celephicus/sbc2023/README.md

Moved to TSA repo. James to advise details.
