celephicus/sbc2023/Docs/SBC2023-IRcodes.odt

SBC2023 – Serial data and IR remote control codes

IR protocol is NEC with a 16 bit system code and 8 bit command code. We have been testing with a common remote with a System Code of 0xef00, but we can use any other code or IR protocol that is required. We suggest that a System Code is chosen that is not in common use by other equipment.

Motion | System Code | Command Code
Continuous motion while IR is received plus preset run-on (note 1)
| | Hexadecimal
Head/Backrest up | 0xef00 | 0x04
Head/Backrest Down | | 0x05
Leg/Foot up | | 0x06
Leg/Foot down | | 0x07
Bed Up | | 0x08
Bed Down | | 0x09
Tilt/Trendellenburg up | | 0x0a
Tilt/Trendellenburg down | | 0x0b
Go to Preset positions (note 2)
Preset 1 | 0xef00 | 0x10
Preset 2 | | 0x11
Preset 3 | | 0x12
Preset 4 | | 0x13

Programming instructions (note 3)
Learn Preset 1 | | 0xef00 | 0x14
Learn Preset 2 | | | 0x15
Learn Preset 3 | | | 0x16
Learn Preset 4 | | | 0x17

System Wake-up
Wakeup (note 4) | | 0xef00 | 0x00
Stop (note 5) | | | 0x01

Notes

1. Use with systems that just give a single command burst such as speech recognition. The motor will run for a preset time each time the command is received. A series of repeated commands might be needed to reach a desired position. These commands cannot be cancelled as they just run for a short time anyway.
2. These commands may be aborted by the Stop command, or if any IR command is received, or if any RS232 data is received.
3. Programming instructions must be received 3 times within 2 seconds to be valid and responded to.
4. This is a safety function, and the command must sent in response to the user giving a command such as “Bed wake up”. This will bring the bed control out of standby and be available for additional commands. The controller will revert to standby 60 seconds after the end of the last command. The controller LCD backlight will be active while the unit is ready for commands.
5. The STOP command will always stop any of the Move To Preset Position commands. It is not really required as any other command received when this command is active will stop all motion.

Wired serial data format

Codes sent by serial data are sent 9600 BPS, 8NE as a 4 byte sequence:

Byte 1,2 – System code MSB first

Byte 3 – Command code

Byte 4 – Checksum consisting of simple 8 bit addition of previous 3 bytes

E.g to send command “Head Up” the bytes “EF 00 04 F3” are sent.

P:\Bed Controls\2022SBC\SBC2022-IRcodes.docx
