celephicus/sbc2023/Hardware/Tom's Schematic.pdf

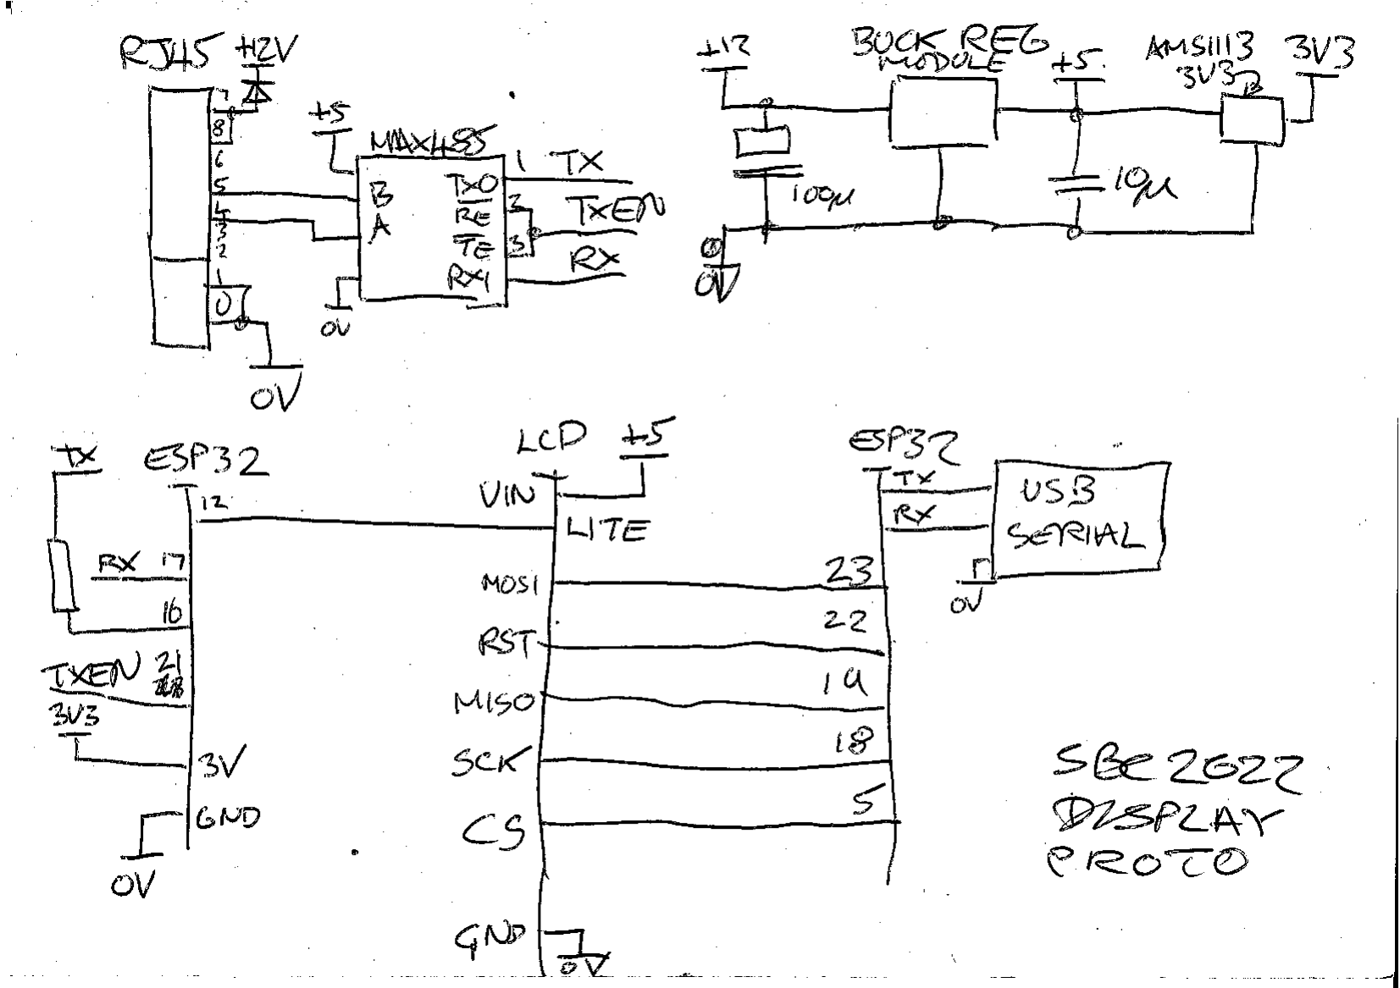
[picture p1: page 1]
