celephicus/sbc2023/Hardware/Workbook.ods

Sheet: Sheet5
Hash 46d2044
baud | 1.5 | 3.5
1200 | 12500.00 | 29166.67 | 12500
2400 | 6250.00 | 14583.33
4800 | 3125.00 | 7291.67
9600 | 1562.50 | 3645.83
19200 | 781.25 | 1822.92
28800 | 520.83 | 1215.28

Sheet: Calcs
Volts Monitor |  |  | Sensor Overvolt
 | Relay/Sensor | Sargood
Rtop(K) | 10 | 10 | Vin(V) | Vout(V) | I(mA)
Rbot(K) | 3.3 | 3.3 | 10.1 | 9.11 | 30 | X | Y | Z
Ratio | 0.248 | 0.248 | 11.2 | 10.3 | 30 | 1 | -77 | -415 | 0.0023691982 | 0.2714901182
 |  |  | 12.6 | 11.7 | 30
Ref(V) | 3.3 | 5 | 13 | 12 | 40
Vin.max(V) | 13.300 | 20.152 | 13.3 | 12.17 | 50
 |  |  | 13.7 | 12.38 | 70
Vin(V) | 12.07 | 11.15 | 14.2 | 12.58 | 90
Vadc.meas(V) |  | 2.720 | 14.5 | 12.76 | 100
Error |  | 1.68% | 15.1 | 12.9 | 120
Vadc.calc(V) | 3.3 | 2.767
ADC() | 928 | 566
Blinky LED
Vf.led(V) | 1.84
VCC(V) | 3.3
Rled(R) | 300
Iled(mA) | 4.8666666667

Sheet: Sheet6
07/02/23
Phone | From Sensor |  |  |  | Calculated from XYZ
Angle | Pitch | X | Y | Z | Pitch | Corrected
-86 | -8041 | 163 | -2631 | 413 | -8042 | -9958
-76 | -8666 | 147 | -2585 | -31 | -8667 | -8667
-67 | -7949 | 138 | -2472 | -437 | -7950 | -7950
-56 | -6834 | 127 | -2237 | -879 | -6835 | -6835
-46 | -5717 | 102 | -1946 | -1251 | -5718 | -5718
-36 | -4566 | 81 | -1597 | -1558 | -4567 | -4567
-27 | -3481 | 52 | -1245 | -1789 | -3482 | -3482
-18 | -2306 | 25 | -828 | -1944 | -2307 | -2307
-8 | -1177 | -8 | -425 | -2038 | -1178 | -1178
0 | -32 | -29 | -12 | -2062 | -33 | -33
7 | 781 | -56 | 281 | -2049 | 781 | 781
13 | 1567 | -73 | 565 | -2013 | 1567 | 1567
19 | 2356 | -99 | 850 | -1947 | 2356 | 2356
24 | 2920 | -116 | 1045 | -1866 | 2920 | 2920
28 | 3435 | -131 | 1230 | -1795 | 3435 | 3435
32 | 3939 | -145 | 1383 | -1678 | 3939 | 3939
35 | 4289 | -155 | 1506 | -1614 | 4289 | 4289
39 | 4783 | -174 | 1679 | -1511 | 4783 | 4783
44 | 5281 | -183 | 1828 | -1375 | 5281 | 5281
54 | 6336 | -203 | 2132 | -1050 | 6336 | 6336
59 | 6969 | -217 | 2287 | -818 | 6969 | 6969
67 | 7683 | -230 | 2445 | -524 | 7683 | 7683
73 | 8233 | -237 | 2543 | -247 | 8233 | 8233
78 | 8446 | -248 | 2597 | -45 | 8446 | 8446
82 | 8402 | -250 | 2613 | 112 | 8402 | 9598
89 | 7907 | -254 | 2653 | 445 | 7907 | 10093

Sheet: Sensor BoM
Desig. | Qty | Desc | TSA P/N | Note

Sheet: Relay BoM
From `Relay-1' received by email 4/10/22 12:31
Desig. | Qty | Desc | TSA P/N | Build Note | Schematic Note
BIAS-A,BIAS-B | 2 x 2W | header pins 100mil single row | CON-PHD-SS-40 | Fit wire link.
BIAS-A,BIAS-B | 2 | header shunt | CON-JUMPER | DNF
C1,3,5,6,8,9 | 6 | Cap Cer SM 100n 1206 | CAP-100N-SM
C2 | 1 | 10u Tant SMD | CAP-10U-16V-SM1206
C4 | 1 | Elect 1000u 50V Radial | CAP-1000U-E50V
C7 | 1 | Cap Cer SM 1N0 1206 | CAP-1N-SM
D1 | 1 | Diode SM 1N4001 | DIO-1N4001-SM |  | Replace value with 1N4001
D2 | 1 | Diode SM BAT54C | DIO-BAT54C
J1 | 1 | DC Inlet | CON-DC-SKT-PCB |  | Add note “Fit J1 or J2'
J2 | 1 x 2W | Screw terminal pin headers 24 way | CON-PHD-STERM | DNF
J3-DB | 1 | DB9 RA Female | CON-DB9-SKT-RA-PCB | Fit J3-DB or J3-DIN | Add note “Fit J3-DB or J3-DIN'
J3-DIN | 1 | DIN 8 PCB SKT RA | CON-DIN8-SKTPCB | Fit J3-DB or J3-DIN
J3A | 1 x 20W | Header skt 0.1” dual row RA | CON-PHD-DR-SKT-40
J3B | 1 x 20W | Header pin 0.1” dual row RA | CON-PHD-DR-40
J4 | 1 x 6W | header pins 100mil single row | CON-PHD-SS-40 | DNF
J5 | 1 x 6W | header pins 100mil dual row | CON-PHD-DS-40 | DNF
J9,10 | 2 | Conn RJ45 | CON-RJ45PCBSKT8
LED1 | 1 | LED 3MM Red | LED-3MM-RD
LK1, TP1 | 2 x 2W | header pins 100mil single row | CON-PHD-SS-40 | DNF
LK1 | 1 | header shunt | CON-JUMPER | DNF
PTC1 | 1 | PTC resettable fuse 1A SMD1206 | NON-STOCK
Q1 | 1 | FET SM A3400 | FET-A03400A
R1,5,6,9,13,17 | 6 | Res SM 3K3 1206 | RES-3K3-SM1206 |  | Amend value to '3K3'.
R11,14 | 2 | Res SM 680R 1206 | NON-STOCK |  | Rockby Stock No: 27521 Part No: -- Description: 680R 5% SMD Resistor (1206)
R12,15 | 2 | Res SM 100R 1206 | RES-100R-SM1206
R2,3,4,10,16,18 | 6 | Res SM 10K 1206 | RES-10K-SM1206
R7,19 | 0 | Res SM 0R 1206 | RES-0R-SM1206 | DNF
RLY1-8 | 8 | Relay 5V SPCO | REL-5V-SPDT-QY23
TERM | 1 x 2W | header pins 100mil single row | CON-PHD-SS-40
TERM | 1 | header shunt | CON-JUMPER
U1 | 1 | IC SM MAX485 | IC-MAX485CSA
U2 | 1 | Regulator module 5V | REG-MOD5V
U3 | 1 | MAX4820 | NON-STOCK
U4 | 1 | IC SM STWD100 | NON-STOCK
U5 | 1 | Mod Arduino Pro Mini 8MHz | IC-ARD-PROMINI-3V3
U5 | 2 x 2W | header pins | CON-PHD-SS-40 | Use 2 x 12W headers supplied with module
U5 | 2 x 12W, 2 x 2W | socket strip 2 x 12W | CON-PHD-SKT-SS

Sheet: Relay Test Plan
Preparation
 | Make test harness to access used pins on RJ45. ATN will need pullup.
 | Check in schematic & PCB files into source control.
 | Check in BoM doc.
 | Check in build instructions doc.
Pre Power Up
 | Verify schematic and PCB plots against supplied board to check that you have correct versions.
 | Verify BoM. Check correct parts fitted, verify orientation & component values.
 | Number all boards and record results tagged with board number.
 | Verify board built correctly with no shorts etc.
Power Supply
 | Pull all socketed parts and check for shorts between power rails and ground.
 | Connect voltmeter to monitor regulated rails.
 | Power up via power plug using lab PS set to 12V. Monitor current & regulator output voltages very carefully and be ready to cut power swiftly if required.
 | Verify 5V rail voltage & noise.
 | Verify 3.3V from Arduino regulator.
 | Verify reverse voltage does not damage anything.
 | Verify overvoltage does not damage anything.
Pre Software Checks
 | Verify clocks if they start without software configuration. It is surprising how often crystals don't start properly.
 | Verify reset signal is inactive.
Upload firmware
 | Verify voltages on ISP header before starting.
 | Upload firmware with debugger
 | Verify crystal if required.
 | Check baudrate on console TX line
 | Connect serial terminal and check for correct response.
Bus | Verify ground connections.
 | Verify 12V connections.
 | Verify RS485 A/B bias links.
 | Verify RS485 A/B term link.
Analogue | Verify 12V in monitor to ADC.
 | Verify 12V bus monitor to ADC.
 | Verify Blinky LED.
RS485 Reset | Hold processor in reset
 | Verify RS485 not enabled, check voltage on /RE & DE.
 | Verify ATN inactive
 | Verify RS485 A/B inactive.
RS485 | Monitor signals on Bus connector.
 | Verify RS485 receive, monitor RO to check waveform.
 | Verify ATN drive by setting low with console.
 | Verify RS485 transmit, monitor DI to check waveform.
Relays | Verify all relays work and have contacts to correct pins.
 | Verify all relays open if WDOG stops toggling.
 | Verify DB9 fits
 | Verify DIN-8 bits
 | Verify power rails on correct pins on 20 pin header.
Finally | Install fresh processor.
 | Verify programming by Arduino
