celephicus/sbc2023/Hardware/Sensor-proto-20221125/checkout.ods

Sheet: Sensor Build
Desig. | Qty to Fit | Desc | TSA P/N | Qty on PCB | Checkout Verified | Instructions
BIAS-A,BIAS-B | 2 x 2W | header pins 100mil single row | CON-PHD-SS-40 |  | OK
BIAS-A,BIAS-B | 2 | header shunt | CON-JUMPER |  | OK
C1,3,5,6,8,9 | 6 | Cap Cer SM 100n 1206 | CAP-100N-SM |  | OK
C2 | 1 | 10u Tant SMD | CAP-10U-16V-SM1206 |  | OK
C4 | 1 | Elect 1000u 50V Radial | CAP-1000U-E50V |  | OK | Please do not fit 100uF.
C7 | 1 | Cap Cer SM 1N0 1206 | CAP-1N-SM |  | OK
D1 | 1 | Diode SM 1N4001 | DIO-1N4001-SM |  | OK
D2 | 1 | Diode SM BAT54C | DIO-BAT54C |  | OK
J1 | 1 | DC Inlet | CON-DC-SKT-PCB |  | OK
J2 |  | Screw terminal pin headers 24 way | CON-PHD-STERM | 1 x 2W | OK | Do not fit.
J3-DB | 1 | DB9 RA Female | CON-DB9-SKT-RA-PCB |  | OK
J3-DIN |  | DIN 8 PCB SKT RA | CON-DIN8-SKTPCB | 1 | OK | Do not fit.
J3A | 1 x 20W | Header skt 0.1” dual row RA | CON-PHD-DR-SKT-40 |  | OK | Fit connector side touching PCB, not up in air.
J3B | 1 x 20W | Header pin 0.1” dual row RA | CON-PHD-DR-40 |  | OK | Fit connector side touching PCB, not up in air.
J4 |  | header pins 100mil single row | CON-PHD-SS-40 | 1 x 6W | OK | Do not fit.
J5 |  | header pins 100mil dual row | CON-PHD-DS-40 | 1 x 6W | OK | Do not fit.
J9,10 | 2 | Conn RJ45 | CON-RJ45PCBSKT8 |  | OK
LED1 | 1 | LED 3MM Red | LED-3MM-RD |  | OK | Bend leads to mount midway horizontally & vertically between the two RJ45 sockets
LK1 |  | header pins 100mil single row | CON-PHD-SS-40 | 1 | OK | Do not fit.
TP1 |  | header pins 100mil single row | CON-PHD-SS-40 | 1 | OK | Do not fit.
LK1 |  | header shunt | CON-JUMPER | 1 | OK | Do not fit.
PTC1 | 1 | PTC resettable fuse 1A SMD1206 | NON-STOCK
Q1 | 1 | FET SM A3400 | FET-A03400A |  | OK
R1 | 1 | Res SM 300R 1206 | RES-300R-SM1206 |  | OK
R5 | 1 | Res SM 3K3 1206 | RES-3K3-SM1206 |  | OK
R6 | 1 | Res SM 3K3 1206 | RES-3K3-SM1206 |  | OK
R9 | 1 | Res SM 3K3 1206 | RES-3K3-SM1206 |  | OK
R13 | 1 | Res SM 3K3 1206 | RES-3K3-SM1206 |  | OK
R17 | 1 | Res SM 3K3 1206 | RES-3K3-SM1206 |  | OK
R11 | 1 | Res SM 680R 1206 | NON-STOCK
R14 | 1 | Res SM 680R 1206 | NON-STOCK
R12 | 1 | Res SM 100R 1206 | RES-100R-SM1206 |  | OK
R15 | 1 | Res SM 100R 1206 | RES-100R-SM1206 |  | OK
R2 | 1 | Res SM 10K 1206 | RES-10K-SM1206 |  | OK
R3 | 1 | Res SM 10K 1206 | RES-10K-SM1206 |  | OK
R4 | 1 | Res SM 10K 1206 | RES-10K-SM1206 |  | OK
R10 | 1 | Res SM 10K 1206 | RES-10K-SM1206 |  | OK
R16 | 1 | Res SM 10K 1206 | RES-10K-SM1206 |  | OK
R18 | 1 | Res SM 10K 1206 | RES-10K-SM1206 |  | OK
R7,19 | 0 | Res SM 0R 1206 | RES-0R-SM1206 | 2 | OK | Do not fit.
RLY1-8 | 8 | Relay 5V SPCO | REL-5V-SPDT-QY23 |  | OK
TERM | 1 x 2W | header pins 100mil single row | CON-PHD-SS-40 |  | OK
TERM | 1 | header shunt | CON-JUMPER |  | OK
U1 | 1 | IC SM MAX485 | IC-MAX485CSA |  | OK
U2 | 1 | Regulator module 5V | REG-MOD5V |  | OK
U3 | 1 | MAX4820 | NON-STOCK |  | OK
U4 | 1 | IC SM STWD100 | NON-STOCK |  | OK
U5 | 1 | Mod Arduino Pro Mini 8MHz | IC-ARD-PROMINI-3V3 |  | OK | Make sure it's 8MHz/3.3V.
U5 | 2 x 12W | header pins | CON-PHD-SS-40 |  | OK | Use pins supplied with Arduino
U5 | 2 x 12W, 2 x 2W | socket strip 100mil single rom | CON-PHD-SKT-SS |  | OK
U5 | 2 x 2W | header pins | CON-PHD-SS-40 |  | OK | Mount in A4,A5 & A6,A7 pins.

Sheet: Sensor Checkout
 |  | From BoM |  | Board P1
Desig. | Qty | Desc | TSA P/N | PCBA Inspect | Checkout Note
C1 | 1 | 10u Tant SMD | CAP-10U-16V-SM1206 | OK | OK
C4 | 1 | Elect 47u 25V Radial | CAP-47U-E25V | OK | OK
D2 | 1 | Diode Zener 12V 6W | NON-STOCK | Not Fitted
D1 | 1 | Diode SM 1N4001 | DIO-1N4001-SM | OK
U2 | 1 | IC SM AMS1117CS 5V | Part No? | OK | Vin & Vout swapped, also 3.3V fitted.
R3 | 1 | Res SM 10K 1206 | RES-10K-SM1206 | OK
R6 | 1 | Res SM 4K7 1206 | RES-4K7-SM1206 | OK
C6 | 1 | Cap Cer SM 100n 1206 | CAP-100N-SM | OK
R5 | 1 | Res SM 1K0 1206 | RES-1K0-SM1206 | OK
* | 1 | Mod ADXL345 | IC-AXCL345-M | Not Fitted
R4 | 1 | Res SM 1K0 1206 | RES-1K0-SM1206 | OK
J2 | 1 x 6W | header pins 100mil single row | CON-PHD-SS-40 | Not Fitted | Fitted for debug
R2 | 1 | Res SM 3K3 1206 | RES-3K3-SM1206 | OK
LED1 | 1 | LED 3MM Red | LED-3MM-RD | OK
J3 | 1 x 6W | header pins 100mil dual row | CON-PHD-DS-40 | Not Fitted | Fitted for debug
M1 | 1 | Mod Arduino Pro Mini 8MHz | IC-ARD-PROMINI-3V3 | 16MHZ fitted | Fitted 3.3V 8MHz
M1 | 2 x 12W | header pins | CON-PHD-SS-40
M1 | 2 x 12W, 2 x 2W | socket strip 2 x 12W | CON-PHD-SKT-SS | 2x2w socket not fitted | Fitted 2x2W socket
M1 | 2 x 2W | header pins | CON-PHD-SS-40
R15 | 1 | Res SM 4K7 1206 | RES-4K7-SM1206 | OK
R16 | 1 | Res SM 4K7 1206 | RES-4K7-SM1206 | OK
J13,J14 | 2 x 2W | header pins | CON-PHD-SS-40 | Not Fitted | Fitted
J13,J14 | 2 | header shunt | CON-JUMPER | Not Fitted | Fitted
R7 | 1 | Res SM 4K7 1206 | RES-4K7-SM1206 | OK
R10 | 1 | Res SM 4K7 1206 | RES-4K7-SM1206 | OK
D3 | 1 | Diode SM BAT54C | DIO-BAT54C | OK
U1 | 1 | IC SM MAX485 | IC-MAX485CSA | OK
C2 | 1 | Cap Cer SM 100n 1206 | CAP-100N-SM | OK
R9 | 1 | Res SM 100R 1206 | RES-100R-SM1206 | OK
R8 | 1 | Res SM 680R 1206 | NON-STOCK | leaded res fitted on J9
R11 | 1 | Res SM 680R 1206 | NON-STOCK | 2xR's in parallel
R12 | 1 | Res SM 100R 1206 | RES-100R-SM1206 | OK
C3 | 1 | Cap Cer SM 1N0 1206 | CAP-1N-SM | OK
R13 | 1 | Res SM 10K 1206 | RES-10K-SM1206 | OK
R14 | 1 | Res SM 4K7 1206 | RES-4K7-SM1206 | OK
J9,10 | 2 | Conn RJ45 | CON-RJ45PCBSKT8 | OK
Q1 | 1 | FET SM A3400 | FET-A03400A | OK
 | BIAS-A,BIAS-B | 2 x 2W | header pins 100mil single row | CON-PHD-SS-40 | Not Fitted | Fitted for debug
 | BIAS-A,BIAS-B | 2 | header shunt | CON-JUMPER | Not Fitted | Fitted for debug
 | C1,3,5,6,8,9 | 6 | Cap Cer SM 100n 1206 | CAP-100N-SM | OK
 | C2 | 1 | 10u Tant SMD | CAP-10U-16V-SM1206 | OK | OK
 | C4 | 1 | Elect 1000u 50V Radial | CAP-1000U-E50V | 100uF/50V fitted | OK
 | C7 | 1 | Cap Cer SM 1N0 1206 | CAP-1N-SM | OK
 | D1 | 1 | Diode SM 1N4001 | DIO-1N4001-SM | OK | OK
 | D2 | 1 | Diode SM BAT54C | DIO-BAT54C | OK
 | J1 | 1 | DC Inlet | CON-DC-SKT-PCB | OK | OK
 | J2 | 1 x 2W | Screw terminal pin headers 24 way | CON-PHD-STERM | Not Fitted
 | J3-DB | 1 | DB9 RA Female | CON-DB9-SKT-RA-PCB | OK
 | J3-DIN | 1 | DIN 8 PCB SKT RA | CON-DIN8-SKTPCB | Not Fitted
 | J3A | 1 x 20W | Header skt 0.1” dual row RA | CON-PHD-DR-SKT-40 | OK
 | J3B | 1 x 20W | Header pin 0.1” dual row RA | CON-PHD-DR-40 | OK
 | J4 | 1 x 6W | header pins 100mil single row | CON-PHD-SS-40 | Not Fitted | Fitted for debug
 | J5 | 1 x 6W | header pins 100mil dual row | CON-PHD-DS-40 | Not Fitted | Fitted for debug
 | J9,10 | 2 | Conn RJ45 | CON-RJ45PCBSKT8 | OK
 | LK1 | 1 x 2W | header pins 100mil single row | CON-PHD-SS-40 | Not Fitted | None
 | TP1 | 1 x 2W | header pins 100mil single row | CON-PHD-SS-40 | Not Fitted | Fitted for debug
 | LK1 | 1 | header shunt | CON-JUMPER | Not Fitted | None
 | PTC1 | 1 | PTC resettable fuse 1A SMD1206 | NON-STOCK | Not Fitted
 | Q1 | 1 | FET SM A3400 | FET-A03400A | OK
 | R1 | 1 | Res SM 3K3 1206 | RES-3K3-SM1206 | OK | Change to 300R
 | R5 | 1 | Res SM 3K3 1206 | RES-3K3-SM1206 | OK
 | R6 | 1 | Res SM 3K3 1206 | RES-3K3-SM1206 | OK
 | R9 | 1 | Res SM 3K3 1206 | RES-3K3-SM1206 | OK | None
 | R13 | 1 | Res SM 3K3 1206 | RES-3K3-SM1206 | OK
 | R17 | 1 | Res SM 3K3 1206 | RES-3K3-SM1206 | OK
 | R11 | 1 | Res SM 680R 1206 | NON-STOCK | 2xR's in parallel | Value confirmed
 | R14 | 1 | Res SM 680R 1206 | NON-STOCK | 2xR's in parallel | Value confirmed
 | R12 | 1 | Res SM 100R 1206 | RES-100R-SM1206 | OK
 | R15 | 1 | Res SM 100R 1206 | RES-100R-SM1206 | OK
 | R2 | 1 | Res SM 10K 1206 | RES-10K-SM1206 | OK
 | R3 | 1 | Res SM 10K 1206 | RES-10K-SM1206 | OK
 | R4 | 1 | Res SM 10K 1206 | RES-10K-SM1206 | OK
 | R10 | 1 | Res SM 10K 1206 | RES-10K-SM1206 | 4K7 fitted
 | R16 | 1 | Res SM 10K 1206 | RES-10K-SM1206 | OK
 | R18 | 1 | Res SM 10K 1206 | RES-10K-SM1206 | OK
 | R7,19 | 0 | Res SM 0R 1206 | RES-0R-SM1206 | OK
 | RLY1-8 | 8 | Relay 5V SPCO | REL-5V-SPDT-QY23 | OK
 | TERM | 1 x 2W | header pins 100mil single row | CON-PHD-SS-40 | Not Fitted | Fitted for debug
 | TERM | 1 | header shunt | CON-JUMPER | Not Fitted | Fitted for debug
 | U1 | 1 | IC SM MAX485 | IC-MAX485CSA | OK
 | U2 | 1 | Regulator module 5V | REG-MOD5V | 7805 fitted | Fitted 5V switching reg module.
 | U3 | 1 | MAX4820 | NON-STOCK | OK
 | U4 | 1 | IC SM STWD100 | NON-STOCK | OK
 | U5 | 1 | Mod Arduino Pro Mini 8MHz | IC-ARD-PROMINI-3V3 | 16MHZ fitted | Fitted 3.3V 8MHz
 | U5 | 2 x 12W | header pins | CON-PHD-SS-40 | OK | None
 | U5 | 2 x 12W, 2 x 2W | socket strip 2 x 12W | CON-PHD-SKT-SS | 2x2w socket not fitted | Fitted 2x2W socket
 | U5 | 2 x 2W | header pins | CON-PHD-SS-40 | Not Fitted | Fitted

Sheet: Sensor Test Plan
Category | Action
Preparation | Make test harness to access used pins on RJ45. ATN will need pullup. | OK
 | Check in schematic & PCB files into source control. | OK | Copied from James' email
 | Check in BoM doc. | OK
 | Check in build instructions doc. | OK
Pre Power Up | Verify schematic and PCB plots against supplied board to check that you have correct versions. | OK
 | Verify BoM. Check correct parts fitted, verify orientation & component values. | OK
 | Number all boards and record results tagged with board number. | OK
 | Verify board built correctly with no shorts etc. | OK
Power Supply
 | Pull all socketed parts and check for shorts between power rails and ground. | OK
 | Connect voltmeter to monitor regulated rails. | OK
 | Power up via power plug using lab PS set to 12V. Monitor current & regulator output voltages very carefully and be ready to cut power swiftly if required. | Reg has Vin,Vout swapped. Also 3.3V part fitted.
 | Verify 5V rail voltage & noise. | OK
 | Verify 3.3V from Arduino regulator. | OK
 | Verify reverse voltage does not damage anything. | OK
 | Verify overvolt protection. | OK | Fitted PTC Bourns MF-R005-0 in net BUS_VCC.
Pre Software Checks
 | Verify clocks if they start without software configuration. It is surprising how often crystals don't start properly. | OK
 | Verify reset signal is inactive. | OK
Upload firmware
 | Verify voltages on ISP header before starting. | OK
 | Upload firmware with debugger | OK
 | Verify crystal if required. | OK
 | Check baudrate on console TX line | OK | Wrong baudrate due to 16MHz setting in build and TX/RX reversed in SW.
 | Connect serial terminal and check for correct response. | OK
Bus | Verify ground connections. | OK
 | Verify 12V connections. | OK
 | Verify RS485 A/B bias res.
 | Verify RS485 A/B term res.
Misc
 | Verify 12V bus monitor to ADC. | OK
 | Verify Blinky LED. | OK | Very dim, change R1 to 300R.
 | Verify links to select address. | OK | J6,J7 should have one select & 1 ground per link.
RS485 Reset | Hold processor in reset
 | Verify RS485 not enabled, check voltage on /RE & DE.
 | Verify ATN inactive
 | Verify RS485 A/B inactive.
RS485 | Monitor signals on Bus connector.
 | Verify RS485 receive, monitor RO to check waveform.
 | Verify ATN drive by setting low with console.
 | Verify RS485 transmit, monitor DI to check waveform.
Sensor | Verify tilt sensor
 | Verify flags as fail if accelerometer module not present
 | Verify flags as fail if faults on SPI
Finally | Install fresh processor.
 | Verify programming by Arduino
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
