celephicus/sbc2023/Hardware/Sargood/label.dxf

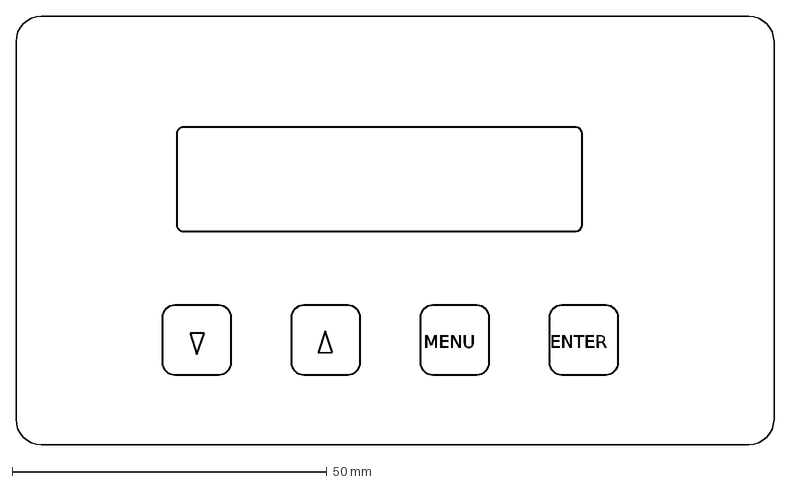
[picture p2: CAD file, 2023-05-17]
Hardware/Sargood/label.dxf
MENU
ENTER
