celephicus/sbc2023/Hardware/Sargood/pcb-template.dxf

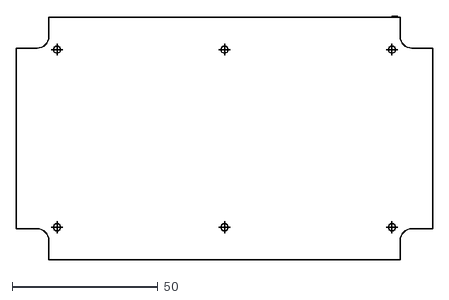
[picture p3: CAD file, 2023-03-23]
Hardware/Sargood/pcb-template.dxf
143.1 x 83.7
