celephicus/sbc2023/Hardware/Relay-proto-20221125/relay-schema-todo.md

# Mods to Relay Schematic from Checkout Nov 2022

1. Swap labels CONSOLE_TX & CONSOLE_RX on processor only. 
2. Change value of R1 to 300R
3. Change value of R10 to 10K.
4. Connect U3/2 (MAX14820) to 3V3.
5. Include pads for all nets on relay driver board.
6. Second set of pads on J3 are not oneected to anything.
7. Pads on J3 are not on 100 mil pitch. 

Add 10 pin header for spare IO to suit logic analyser.
