celephicus/sbc2023/Hardware/Sensor-proto-20221125/SensorTom.pdf

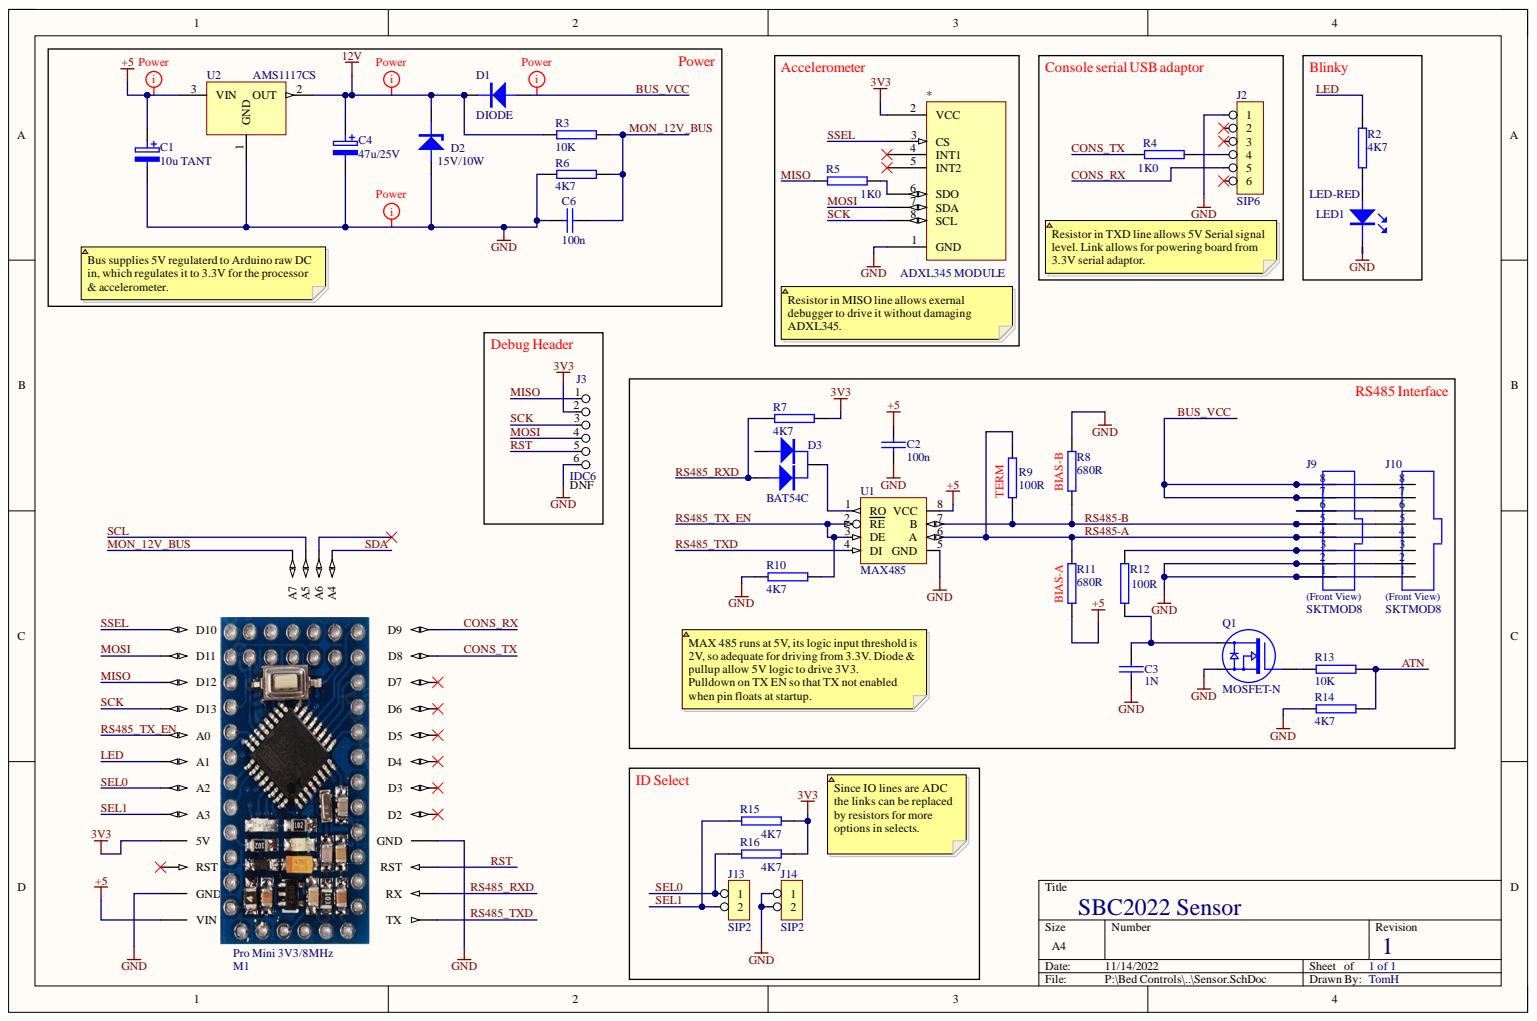
[picture p6: page 1]

Resistor in TXD line allows 5V Serial signal
level. Link allows for powering board from
3.3V serial adaptor.

Bus supplies 5V regulaterd to Arduino raw DC
in, which regulates it to 3.3V for the processor
& accelerometer.

Resistor in MISO line allows exernal
debugger to drive it without damaging
ADXL345.

MAX 485 runs at 5V, its logic input threshold is
2V, so adequate for driving from 3.3V. Diode &
pullup allow 5V logic to drive 3V3.
Pulldown on TX EN so that TX not enabled
when pin floats at startup.

Since IO lines are ADC
the links can be replaced
by resistors for more
options in selects.

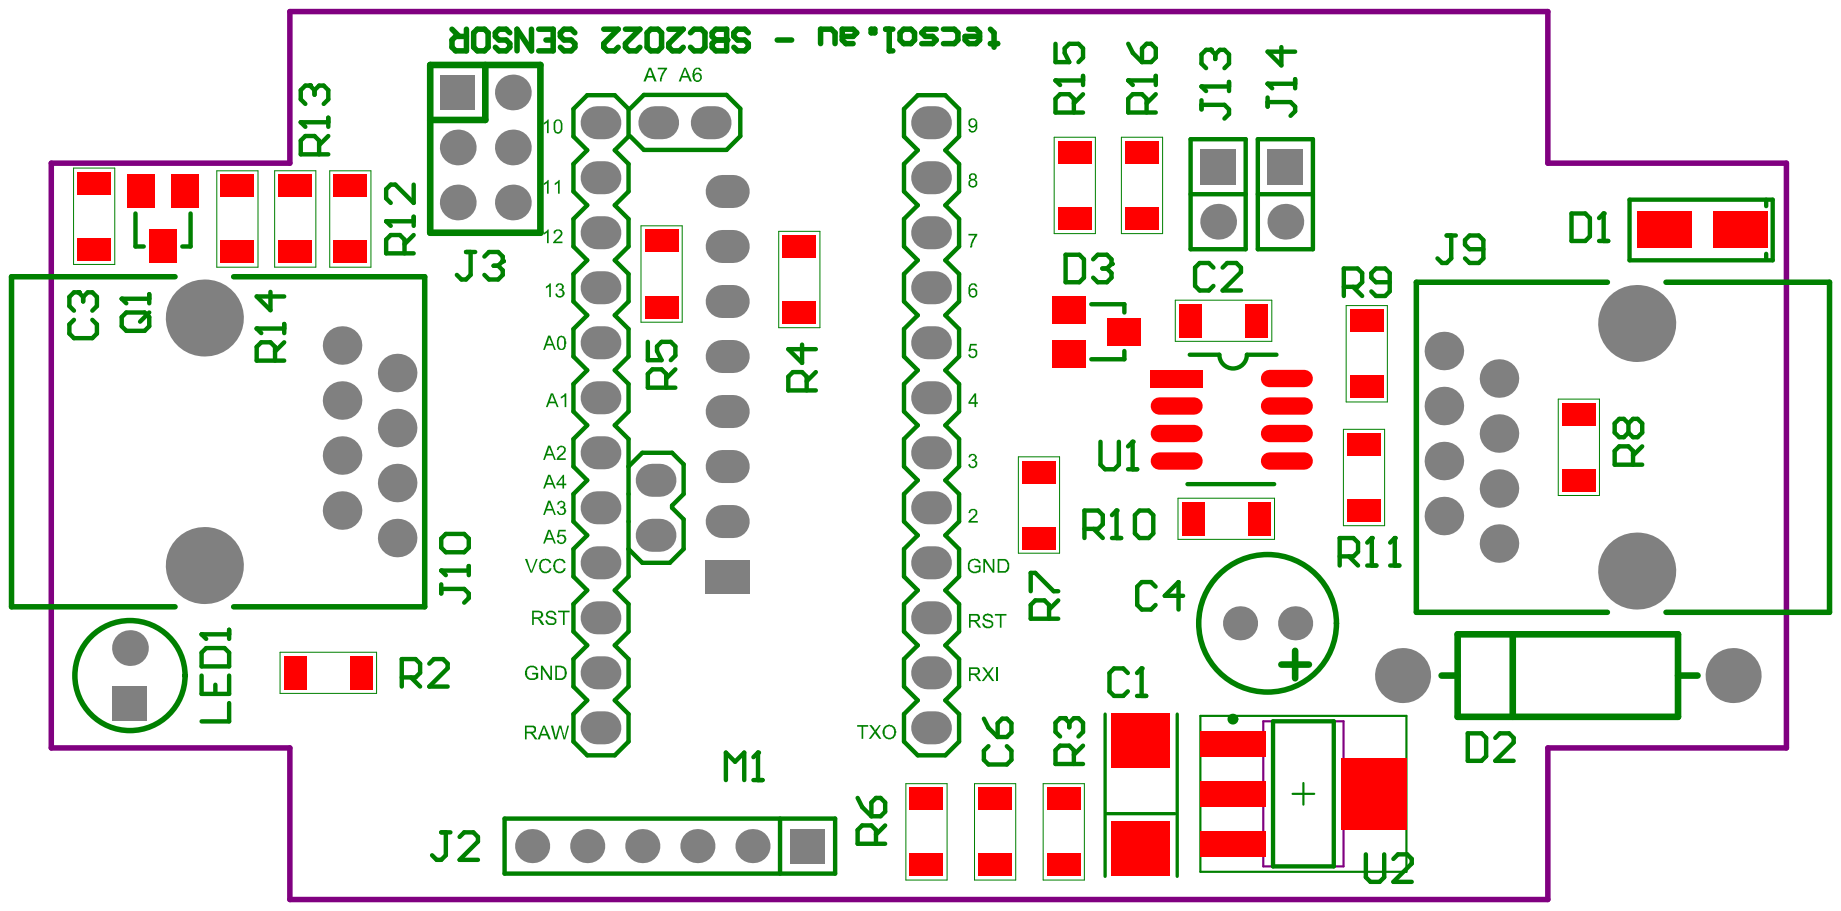
[picture p7: page 2]

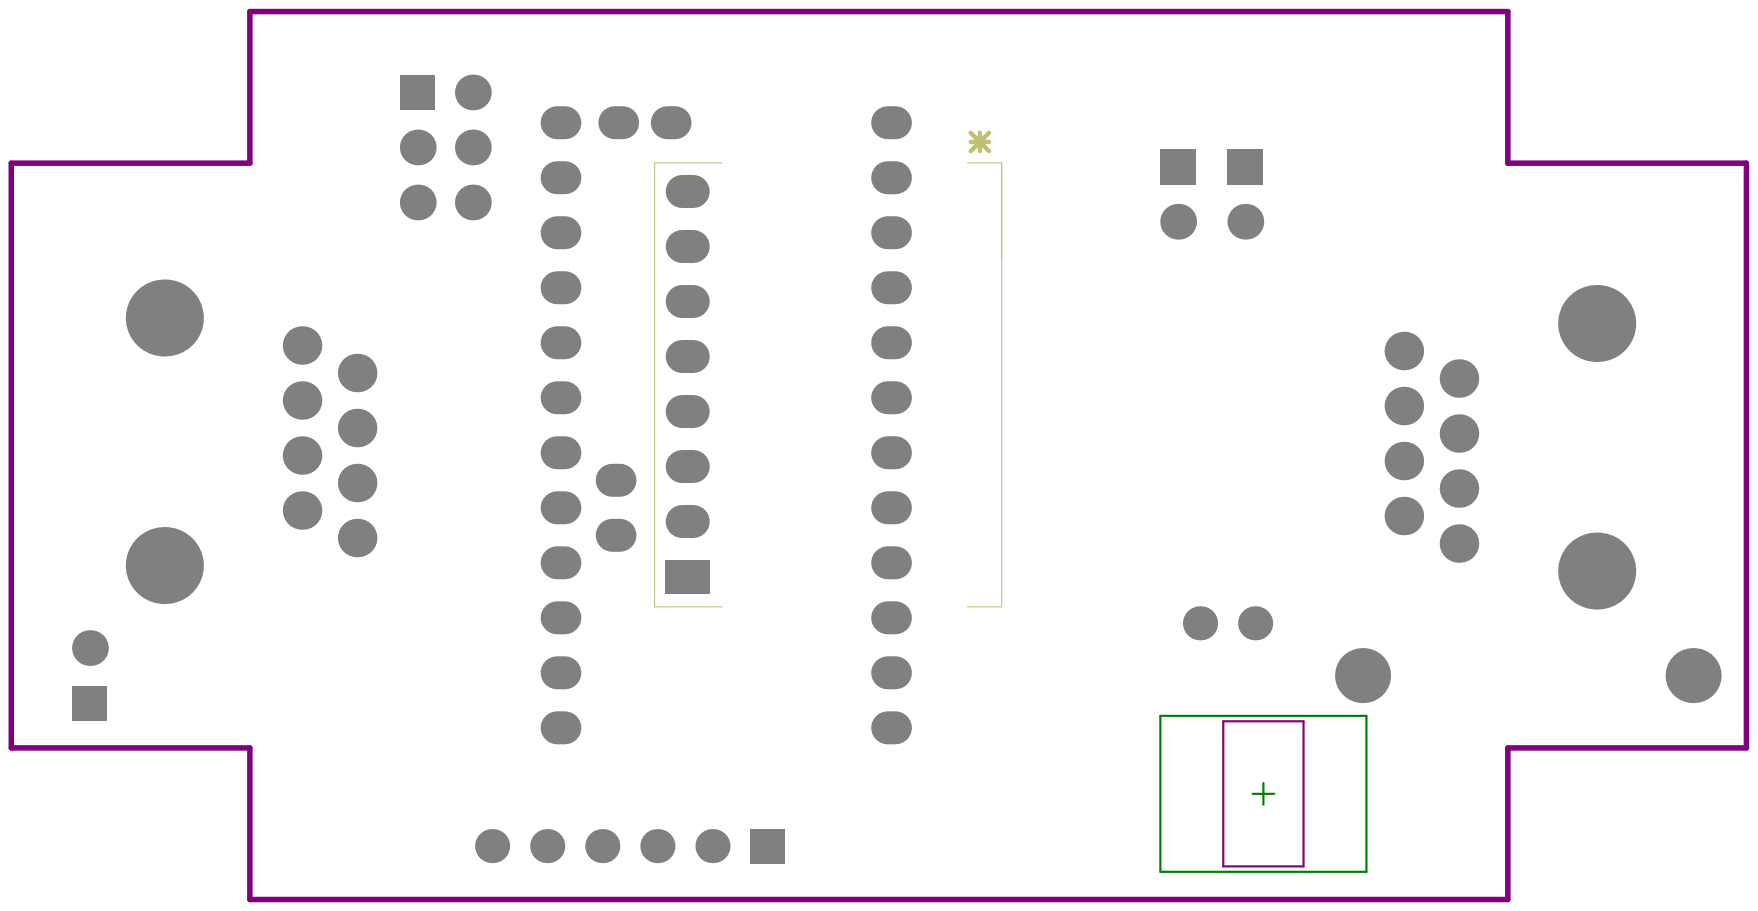
[picture p8: page 3]
