celephicus/sbc2023/Hardware/Relay-proto-20221125/Relay.pdf

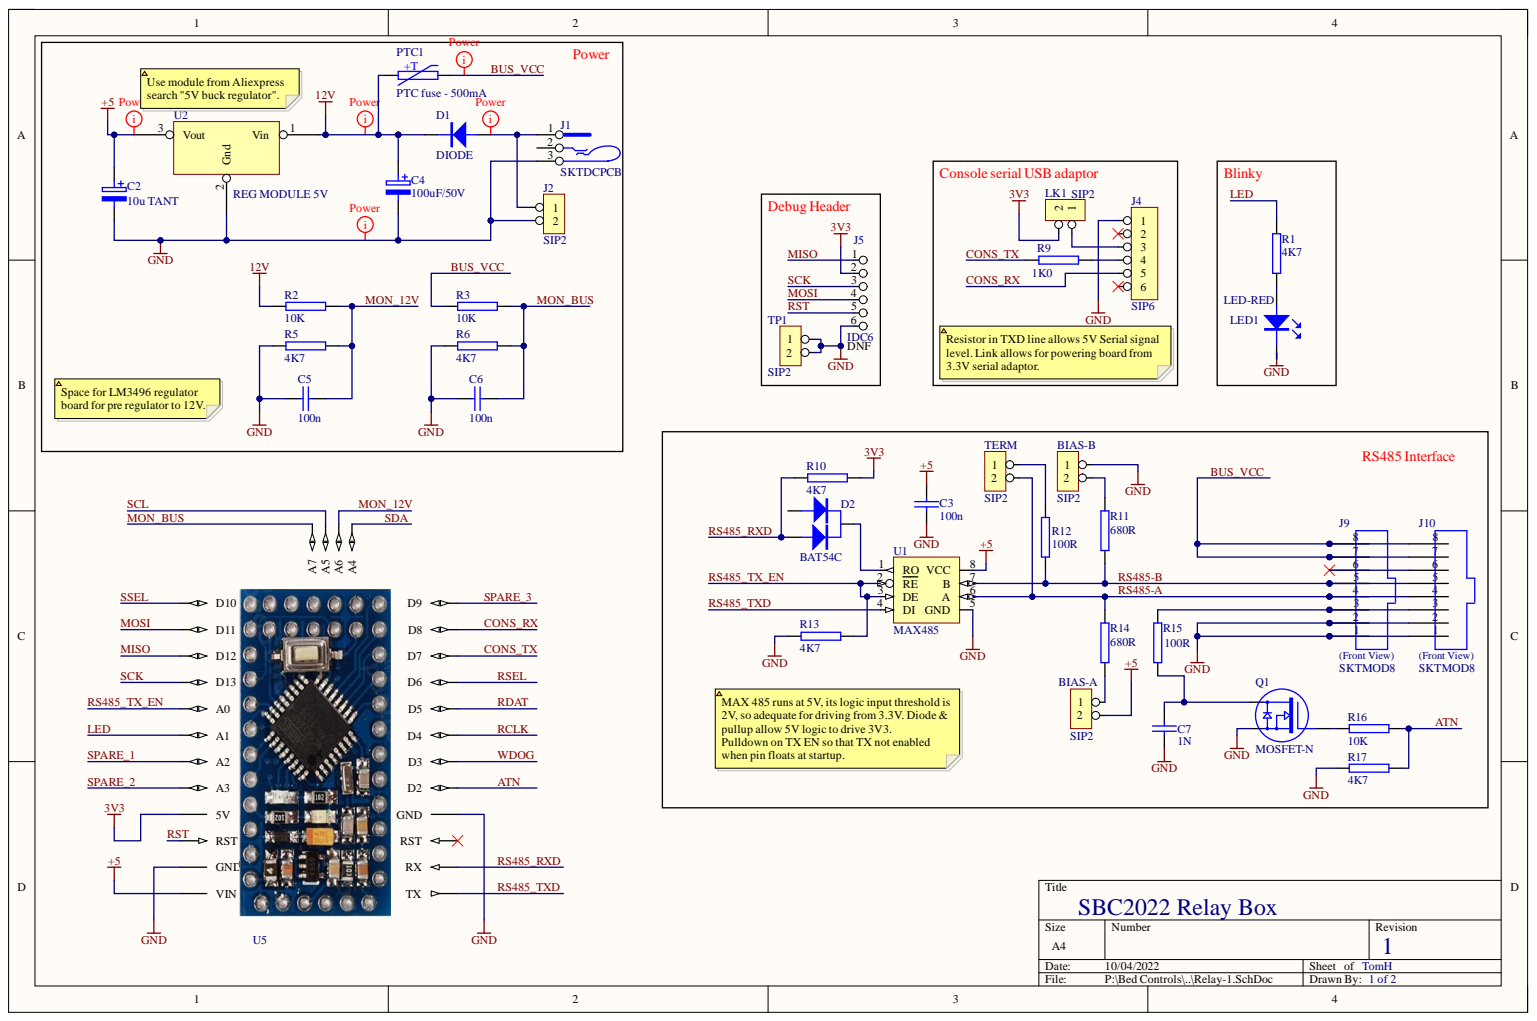
[picture p9: page 1]

Use module from Aliexpress
search "5V buck regulator".
Power

Console serial USB adaptor

Resistor in TXD line allows 5V Serial signal
level. Link allows for powering board from
3.3V serial adaptor.

Space for LM3496 regulator
board for pre regulator to 12V.

MAX 485 runs at 5V, its logic input threshold is
2V, so adequate for driving from 3.3V. Diode &
pullup allow 5V logic to drive 3V3.
Pulldown on TX EN so that TX not enabled
when pin floats at startup.

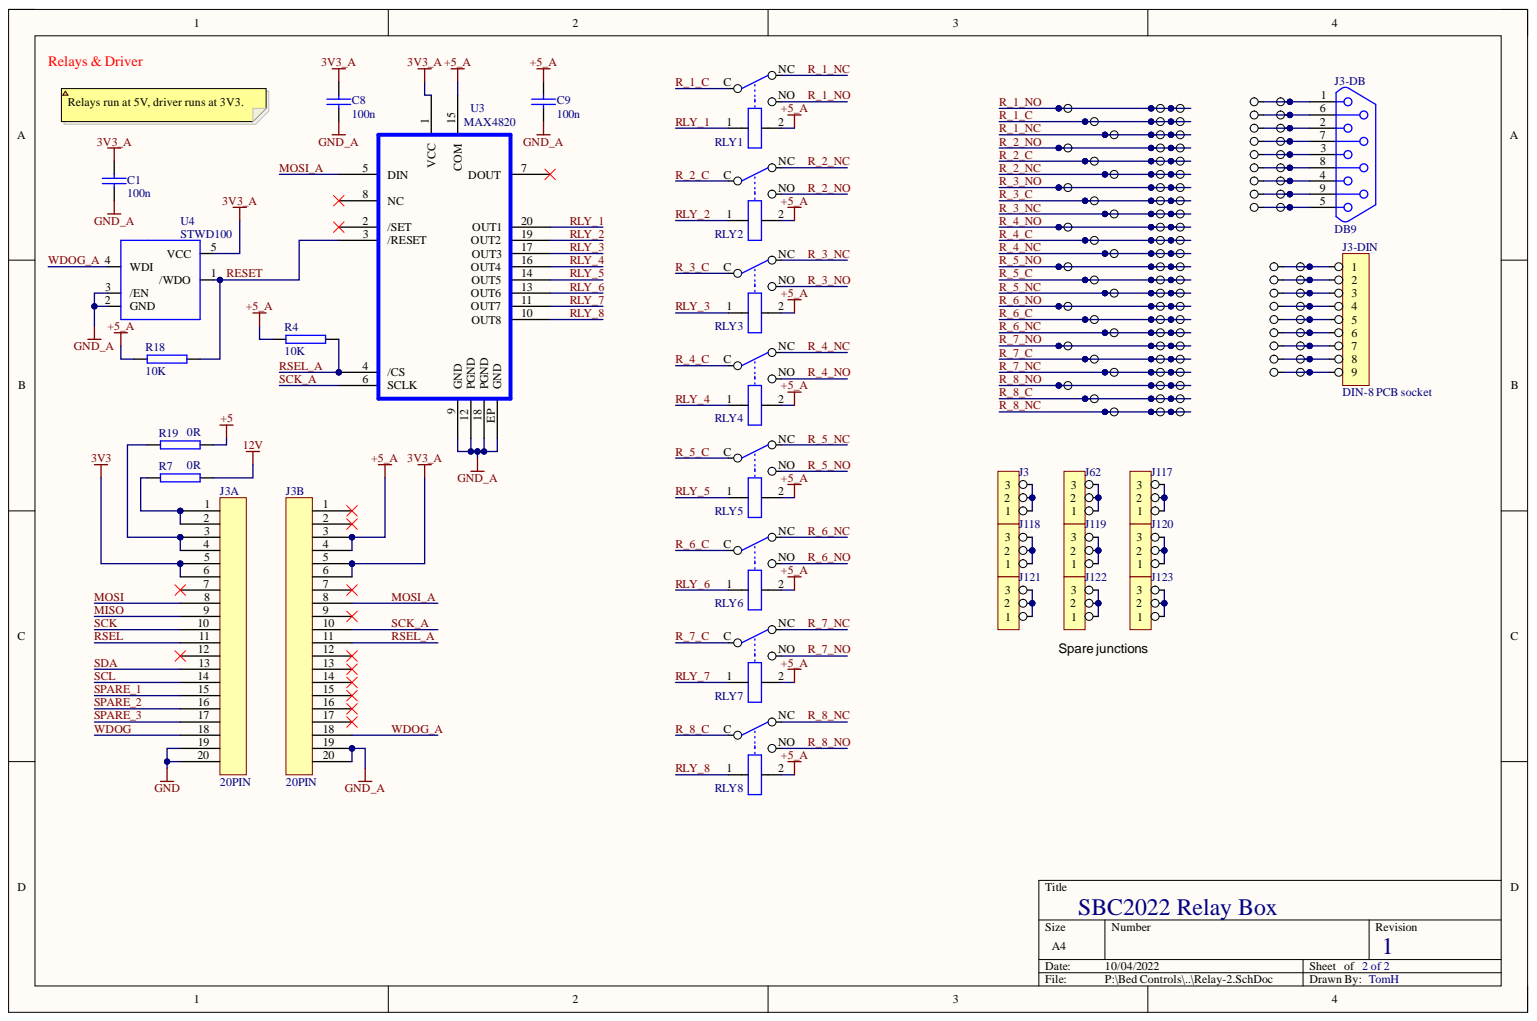
[picture p10: page 2]

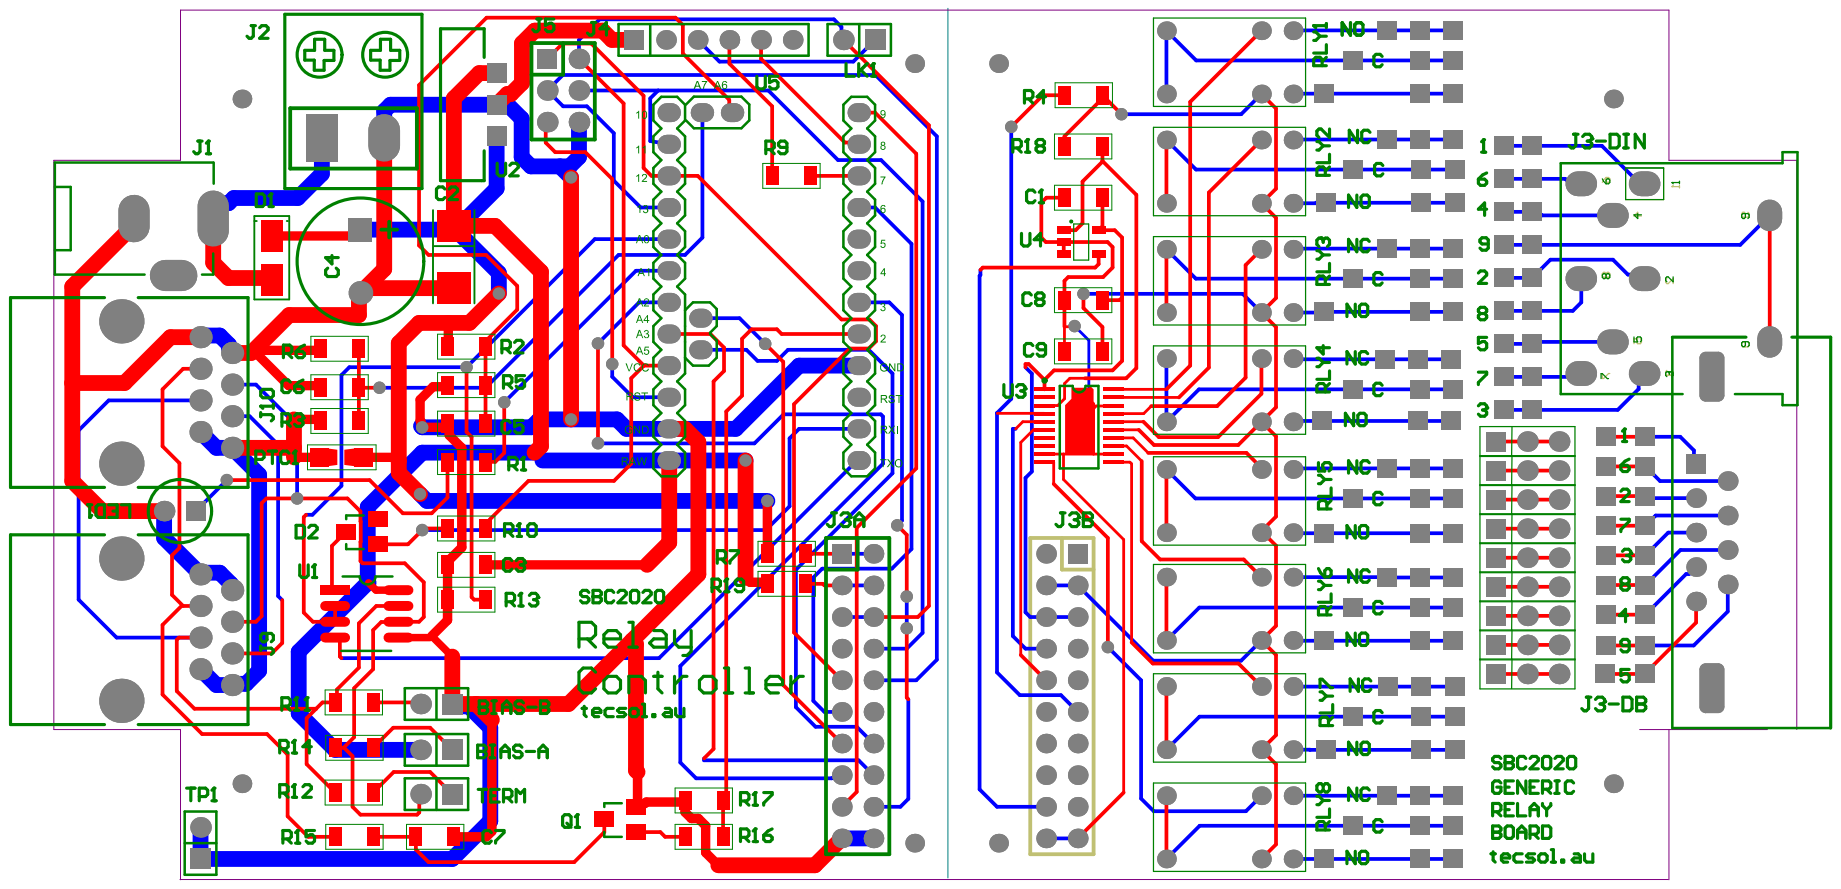
[picture p11: page 3]
