celephicus/sbc2023/Software/Sargood/Sargood/event.local.h

#ifndef ARGS_INFILE__
#define ARGS_INFILE__

/* [[[  Begin event definitions: format <event-name> <comment>

	COMMAND_START	Command received, code in p8.
	COMMAND_DONE	Command done, code in p8, status code in p16.
	COMMAND_STACK	Command tacked on running command.
	CMD_STATE_CHANGE Handler state machine has new state set.
	SW_TOUCH_LEFT	Touch switch LEFT
	SW_TOUCH_RIGHT	Touch switch RIGHT
	SW_TOUCH_MENU	Touch switch MENU
	SW_TOUCH_RET	Touch switch RET
	UPDATE_MENU		Update menu item value on LCD.
	IR_REC			IR command received, p8=cmd, p16=cmd
	REMOTE_CMD		Command from RS232 port, p8=byte2, p16=byte0..1.
	SLEW_TARGET		Slew target pos; p8: axis idx; p16=target
	SLEW_START		Slew start pos; p8: axis idx; p16=current
	SLEW_STOP		Slew stop pos; p8: axis idx; p16=current
	SLEW_FINAL		Slew rest pos; p8: axis idx; p16=current
	RELAY_WRITE		Relay write; p8: relay
	DEBUG_SLEW_ORDER Chosen slew order, p8=index.

   >>> End event definitions, begin generated code. */

// Event IDs
enum {
    EV_NIL = 0,                         // Null event signals no events on queue.
    EV_DEBUG_SM_STATE_CHANGE = 1,       // Debug event to signal a state change, p8 has SM ID, p16 has new state. Not queued.
    EV_SM_ENTRY = 2,                    // Sent by state machine runner, never traced.
    EV_SM_EXIT = 3,                     // Sent by state machine runner, never traced.
    EV_SM_SELF = 4,                     // Used by state machine to send an event to self.
    EV_TIMER = 5,                       // Event timer, p8 = state machine, p16 = cookie.
    EV_DEBUG_TIMER_ARM = 6,             // Debug event, timer start, p8 is timer ID, p16 is timeout.
    EV_DEBUG_TIMER_STOP = 7,            // Debug event, timer stop, p8 is timer ID, p16 is timeout.
    EV_DEBUG_QUEUE_FULL = 8,            // Debug event, failed to queue event ID in p8.
    EV_DEBUG = 9,                       // Generic debug event.
    EV_COMMAND_START = 10,              // Command received, code in p8.
    EV_COMMAND_DONE = 11,               // Command done, code in p8, status code in p16.
    EV_COMMAND_STACK = 12,              // Command tacked on running command.
    EV_CMD_STATE_CHANGE = 13,           // Handler state machine has new state set.
    EV_SW_TOUCH_LEFT = 14,              // Touch switch LEFT
    EV_SW_TOUCH_RIGHT = 15,             // Touch switch RIGHT
    EV_SW_TOUCH_MENU = 16,              // Touch switch MENU
    EV_SW_TOUCH_RET = 17,               // Touch switch RET
    EV_UPDATE_MENU = 18,                // Update menu item value on LCD.
    EV_IR_REC = 19,                     // IR command received, p8=cmd, p16=cmd
    EV_REMOTE_CMD = 20,                 // Command from RS232 port, p8=byte2, p16=byte0..1.
    EV_SLEW_TARGET = 21,                // Slew target pos; p8: axis idx; p16=target
    EV_SLEW_START = 22,                 // Slew start pos; p8: axis idx; p16=current
    EV_SLEW_STOP = 23,                  // Slew stop pos; p8: axis idx; p16=current
    EV_SLEW_FINAL = 24,                 // Slew rest pos; p8: axis idx; p16=current
    EV_RELAY_WRITE = 25,                // Relay write; p8: relay
    EV_DEBUG_SLEW_ORDER = 26,           // Chosen slew order, p8=index.
    COUNT_EV = 27,                      // Total number of events defined.
};

// Size of trace mask in bytes.
#define EVENT_TRACE_MASK_SIZE 4

// Event Names.
#define DECLARE_EVENT_NAMES()                                                           \
 static const char EVENT_NAMES_0[] PROGMEM = "NIL";                                     \
 static const char EVENT_NAMES_1[] PROGMEM = "DEBUG_SM_STATE_CHANGE";                   \
 static const char EVENT_NAMES_2[] PROGMEM = "SM_ENTRY";                                \
 static const char EVENT_NAMES_3[] PROGMEM = "SM_EXIT";                                 \
 static const char EVENT_NAMES_4[] PROGMEM = "SM_SELF";                                 \
 static const char EVENT_NAMES_5[] PROGMEM = "TIMER";                                   \
 static const char EVENT_NAMES_6[] PROGMEM = "DEBUG_TIMER_ARM";                         \
 static const char EVENT_NAMES_7[] PROGMEM = "DEBUG_TIMER_STOP";                        \
 static const char EVENT_NAMES_8[] PROGMEM = "DEBUG_QUEUE_FULL";                        \
 static const char EVENT_NAMES_9[] PROGMEM = "DEBUG";                                   \
 static const char EVENT_NAMES_10[] PROGMEM = "COMMAND_START";                          \
 static const char EVENT_NAMES_11[] PROGMEM = "COMMAND_DONE";                           \
 static const char EVENT_NAMES_12[] PROGMEM = "COMMAND_STACK";                          \
 static const char EVENT_NAMES_13[] PROGMEM = "CMD_STATE_CHANGE";                       \
 static const char EVENT_NAMES_14[] PROGMEM = "SW_TOUCH_LEFT";                          \
 static const char EVENT_NAMES_15[] PROGMEM = "SW_TOUCH_RIGHT";                         \
 static const char EVENT_NAMES_16[] PROGMEM = "SW_TOUCH_MENU";                          \
 static const char EVENT_NAMES_17[] PROGMEM = "SW_TOUCH_RET";                           \
 static const char EVENT_NAMES_18[] PROGMEM = "UPDATE_MENU";                            \
 static const char EVENT_NAMES_19[] PROGMEM = "IR_REC";                                 \
 static const char EVENT_NAMES_20[] PROGMEM = "REMOTE_CMD";                             \
 static const char EVENT_NAMES_21[] PROGMEM = "SLEW_TARGET";                            \
 static const char EVENT_NAMES_22[] PROGMEM = "SLEW_START";                             \
 static const char EVENT_NAMES_23[] PROGMEM = "SLEW_STOP";                              \
 static const char EVENT_NAMES_24[] PROGMEM = "SLEW_FINAL";                             \
 static const char EVENT_NAMES_25[] PROGMEM = "RELAY_WRITE";                            \
 static const char EVENT_NAMES_26[] PROGMEM = "DEBUG_SLEW_ORDER";                       \
                                                                                        \
 static const char* const EVENT_NAMES[] PROGMEM = {                                     \
   EVENT_NAMES_0,                                                                       \
   EVENT_NAMES_1,                                                                       \
   EVENT_NAMES_2,                                                                       \
   EVENT_NAMES_3,                                                                       \
   EVENT_NAMES_4,                                                                       \
   EVENT_NAMES_5,                                                                       \
   EVENT_NAMES_6,                                                                       \
   EVENT_NAMES_7,                                                                       \
   EVENT_NAMES_8,                                                                       \
   EVENT_NAMES_9,                                                                       \
   EVENT_NAMES_10,                                                                      \
   EVENT_NAMES_11,                                                                      \
   EVENT_NAMES_12,                                                                      \
   EVENT_NAMES_13,                                                                      \
   EVENT_NAMES_14,                                                                      \
   EVENT_NAMES_15,                                                                      \
   EVENT_NAMES_16,                                                                      \
   EVENT_NAMES_17,                                                                      \
   EVENT_NAMES_18,                                                                      \
   EVENT_NAMES_19,                                                                      \
   EVENT_NAMES_20,                                                                      \
   EVENT_NAMES_21,                                                                      \
   EVENT_NAMES_22,                                                                      \
   EVENT_NAMES_23,                                                                      \
   EVENT_NAMES_24,                                                                      \
   EVENT_NAMES_25,                                                                      \
   EVENT_NAMES_26,                                                                      \
 }

// Event Descriptions.
#define DECLARE_EVENT_DESCS()                                                                                                               \
 static const char EVENT_DESCS_0[] PROGMEM = "Null event signals no events on queue.";                                                      \
 static const char EVENT_DESCS_1[] PROGMEM = "Debug event to signal a state change, p8 has SM ID, p16 has new state. Not queued.";          \
 static const char EVENT_DESCS_2[] PROGMEM = "Sent by state machine runner, never traced.";                                                 \
 static const char EVENT_DESCS_3[] PROGMEM = "Sent by state machine runner, never traced.";                                                 \
 static const char EVENT_DESCS_4[] PROGMEM = "Used by state machine to send an event to self.";                                             \
 static const char EVENT_DESCS_5[] PROGMEM = "Event timer, p8 = state machine, p16 = cookie.";                                              \
 static const char EVENT_DESCS_6[] PROGMEM = "Debug event, timer start, p8 is timer ID, p16 is timeout.";                                   \
 static const char EVENT_DESCS_7[] PROGMEM = "Debug event, timer stop, p8 is timer ID, p16 is timeout.";                                    \
 static const char EVENT_DESCS_8[] PROGMEM = "Debug event, failed to queue event ID in p8.";                                                \
 static const char EVENT_DESCS_9[] PROGMEM = "Generic debug event.";                                                                        \
 static const char EVENT_DESCS_10[] PROGMEM = "Command received, code in p8.";                                                              \
 static const char EVENT_DESCS_11[] PROGMEM = "Command done, code in p8, status code in p16.";                                              \
 static const char EVENT_DESCS_12[] PROGMEM = "Command tacked on running command.";                                                         \
 static const char EVENT_DESCS_13[] PROGMEM = "Handler state machine has new state set.";                                                   \
 static const char EVENT_DESCS_14[] PROGMEM = "Touch switch LEFT";                                                                          \
 static const char EVENT_DESCS_15[] PROGMEM = "Touch switch RIGHT";                                                                         \
 static const char EVENT_DESCS_16[] PROGMEM = "Touch switch MENU";                                                                          \
 static const char EVENT_DESCS_17[] PROGMEM = "Touch switch RET";                                                                           \
 static const char EVENT_DESCS_18[] PROGMEM = "Update menu item value on LCD.";                                                             \
 static const char EVENT_DESCS_19[] PROGMEM = "IR command received, p8=cmd, p16=cmd";                                                       \
 static const char EVENT_DESCS_20[] PROGMEM = "Command from RS232 port, p8=byte2, p16=byte0..1.";                                           \
 static const char EVENT_DESCS_21[] PROGMEM = "Slew target pos; p8: axis idx; p16=target";                                                  \
 static const char EVENT_DESCS_22[] PROGMEM = "Slew start pos; p8: axis idx; p16=current";                                                  \
 static const char EVENT_DESCS_23[] PROGMEM = "Slew stop pos; p8: axis idx; p16=current";                                                   \
 static const char EVENT_DESCS_24[] PROGMEM = "Slew rest pos; p8: axis idx; p16=current";                                                   \
 static const char EVENT_DESCS_25[] PROGMEM = "Relay write; p8: relay";                                                                     \
 static const char EVENT_DESCS_26[] PROGMEM = "Chosen slew order, p8=index.";                                                               \
                                                                                                                                            \
 static const char* const EVENT_DESCS[] PROGMEM = {                                                                                         \
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
   EVENT_DESCS_26,                                                                                                                          \
 }

// ]]] End generated code.

#endif //  ARGS_INFILE__
