celephicus/sbc2023/Software/Shared/2022SBC/sbc2022_modbus.h

// Our MODBUS presence is limited to two blocks of holding registers.
// Address zero mirror the internal REGS and are read only.
// Other addresses are for the relay or sensors. For simplicity they all use the same address.
//
enum {
	SBC2022_MODBUS_REGISTER_RELAY = 100,
	SBC2022_MODBUS_REGISTER_SENSOR_TILT = 100,
	SBC2022_MODBUS_REGISTER_SENSOR_STATUS = 101,
	SBC2022_MODBUS_REGISTER_SENSOR_SAMPLE_COUNT = 102,
};

// Status codes from Relay & Sensor modules.
enum {
	SBC2022_MODBUS_STATUS_SLAVE_NO_RESPONSE = 0,				// Slave no response (code generated by master, never sent by slave).
	SBC2022_MODBUS_STATUS_SLAVE_NOT_WORKING = 1,				// Slave not working (code sent from slave).
	SBC2022_MODBUS_STATUS_SLAVE_BAD_RESPONSE = 2,				// Slave response received, but there was an error.

	SBC2022_MODBUS_STATUS_SLAVE_OK = 100,						// Slave good.
	SBC2022_MODBUS_STATUS_SLAVE_MOTION_POS = 101,				// Sensor moving up.
	SBC2022_MODBUS_STATUS_SLAVE_MOTION_NEG = 102,				// Sensor moving down.
};

// Predicate to test for a faulty status code.
static inline bool isSlaveStatusFault(uint8_t status) { return status < SBC2022_MODBUS_STATUS_SLAVE_OK; }

// Slave IDs (addresses).
enum {
	SBC2022_MODBUS_SLAVE_ID_RELAY = 16,
	SBC2022_MODBUS_SLAVE_ID_SENSOR_0 = 1,		// First tilt sensor, others follow on from here.
	SBC2022_MODBUS_SLAVE_COUNT_SENSOR = 4,
};
const uint16_t SBC2022_MODBUS_TILT_FAULT = 32767;	// Tilt sensor value returned on fault.
