celephicus/sbc2023/(commit log)

2022-08-30 Simple RS485 console.
    [Relay.csv]
2022-08-30 Added simple MAX4820 relay driver.
2022-09-01 Working MODBUS & accelerometer. Made a start on ADXL345 driver.
2022-09-07 Display driver working.
2022-09-07 Display working. Moved common code out to Common. New modbus driver.
2022-09-10 Sort of working to read the accelerometer.
2022-09-11 Atmel Studio project for Relay.
2022-09-11 Modbus driver now has a buffer for response data that is the same format as the request frame. Also fixed problem with modbus 16 bit access.
    [ADXL345.h, Relay-arduino.ino, console-config-default.h, console.cpp, console.h, fconsole.cpp, fconsole.h, gpio.h]
2022-09-12 Added script for generating gpio from spreadsheet.
    [gpio.csv]
2022-09-12 Missed these out.
    [Relay.csv]
2022-09-24 Schematics from James.
2022-09-24 Big reorganise to copy common files to src/Common dir for Arduino projects. These are set readonly and not tracked by git.
2022-09-25 Now have debug, but enabling watchdog causes strange crash like wdog period set very small. Everything else seems to work.
    [Relay-arduino.ino, adc_driver.cpp, adc_driver.h, common.cpp, debug.cpp, debug.h, project_config.h]
2022-09-27 Massive transplant of framework from CallStation. Working on getting the MODBUS latency down, looks to have been mainly the overhead of dumping the packets to the console.
    [gpio.csv]
2022-09-28 Getting Sensor board out....
    [gpio.csv]
2022-09-28 Final version of Sensor?
    [Workbook.ods]
2022-09-28 Starting Relay lite project that just does what it hasd to do but is understandable by a newcomer.
    [gpio.csv]
2022-09-29 Working console.
    [Relay-gpio.csv]
2022-09-29 Whoops forgot modified build scripts.
    [gpio.csv]
2022-09-29 Some files got copied into Relay-l-as that didn't belong.
    [event.local.h, project_config.h, regs.local.h, version.h]
2022-09-30 Added old sequencer to utils. Added buffer type to utils. Added modbus, rewrote to use new buffer type. Reinstated consolePrint() Added blinky LED driver to main. Added relay driver to main. Version 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
2022-09-30 Added regs with code that can be generated from csv file when I write the script.
    [regs.csv]
2022-09-30 Added adc_driver & eeprom_driver into new file `dev' intended for device driver sorts of things.
2022-09-30 Added watchdog driver to dev, regs now complete.
2022-10-04 Removing unused files from Relay-l, moved to local dir tryout.4
2022-10-05 New file driver with drivery things in it. MODBUS response now has overflow handling for buffer copy.
2022-10-10 Event trace mask now external func, made a start on tests for trace mask.
2022-10-10 Added trace mask to NV. No idea if this works.
2022-10-18 Rewrite for ESP32 support.
2022-10-18 Relay builds with Shared/Common code. Unknown if it works.
2022-10-23 Did stuff on workbook.
    [Workbook.ods]
2022-10-23 Reorganised shared code as dev no use for ESP32.
2022-10-23 Relay-l builds.
2022-10-23 Rewrote regs generator script to use a defs file to write a .h file included in regs.h. Moved regs files to Shared/Common.
    [regs.csv]
2022-10-23 Removed tests for event & utils from Relay-l-Arduino since they were copied to Shared/Common. Moved common Modbus defs to Shared/Common.
2022-10-23 Found a bug in Arduino's version of gcc, see comment in driver.cpp.
    [driver.cpp, project_config.h]
2022-10-23 Checking out Arduino build by manually copying files from Shared. This is not a solution. This is only committed so that there is something working to refer to if things go wrong later whilst investi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
    [console.cpp, console.h, dev.cpp, dev.h, event.cpp, event.h, modbus.cpp, modbus.h]
2022-10-24 Moved source for Relay to Relay-l, which is where the build now happens with AtmelStudio. Added a script to copy all source to Relay-l-arduino for an Arduino build.
    [Relay-gpio.csv]
2022-10-26 Rewriting modbus as I don't understand it anymore! Strange warning in utils to do with the compiler used for testing thinking that the indentation was misleading. Who knows if it was but fixed now.
    [modbus.cpp, modbus.h, utils.cpp]
2022-10-27 Fixing silly bugs in modbus.
    [modbus.cpp, modbus.h, project_config.h]
2022-10-27 Fixed possible overflow in modbus send.
    [modbus.cpp, modbus.h, project_config.h]
2022-10-28 Changed error reporting to just use callback events, much cleaner. Added example of master handling responses from slaves.
    [console.h, modbus.cpp, modbus.h, project_config.h]
2022-10-28 Removed all usage pf atomic.h for critical sections as not at all portable. Fixed Release build, saves about 5% of code size.
    [project_config.h, regs.cpp]
2022-11-01 Redid component desigs in workbook since did not match latest schematic for sensor.
    [Workbook.ods]
2022-11-01 Changed ATN FET gate pulldown to 3K3 so when micro in reset with port pullup enabled the FET i not turned on.
    [Workbook.ods]
2022-11-03 Fixed dead code left in from initialisation in threshold scanner.
    [project_config.h, utils.cpp, utils.h]
2022-11-08 Gpio script now uses codegen module. Much easier to write now.
    [gpio.csv, t.csv]
2022-11-08 Moved modbus callback to driver where it belongs. Removed modbus autosend as I do have a digital CRO so no need to send periodically to trigger. Added back asserts and runtime error handling. Added s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
    [dev.cpp, driver.cpp, project_config.h, utils.cpp, utils.h]
2022-11-13 Integrated new gpio & regs scripts into Relay build. Removed event system as not required for a small project. Switched to new Microchip Studio so project files have mutated.
2022-11-13 Removed dead events code from Relay.
2022-11-14 Renaming old Relay to Relay/history.
    [gpio.csv]
2022-11-14 Removed old Atmel Studio relay project.
2022-11-14 Moving relay-l to relay.
    [Relay-gpio.csv]
2022-11-14 Renamed relay-l to relay and it builds.
    [Relay-gpio.csv]
2022-11-14 Relay arduino builds.
2022-11-14 End of Relay-l.
2022-11-14 Sensor builds but requires lots of fiddling when copying from Relay. Also had to do a tweak to the gpio script to cope with unused pins.
    [gpio.csv]
2022-11-14 Lots of small edits to Relay in order that it can be transmogrified into Sensor.
    [gpio.csv]
2022-11-14 Renamed project relay to slave.
    [gpio.csv]
2022-11-14 Renamed Relay-as to Slave. Renamed remainder of Relay to Relay-old.
    [gpio.csv]
2022-11-14 Removed Slave as might just as well use Relay as the master.
    [gpio.csv]
2022-11-15 Deleted old Sensor project and Arduino dir.
    [gpio.csv]
2022-11-15 Finished messing with Relay, now can be converted simply to Sensor.
    [gpio.csv]
2022-11-15 Added back Arduino projects for Relay & Sensor.
2022-11-16 Added accelerometer to Sensor with rudimentary error checking.
    [ADXL345.h, Slave.cpp, driver.cpp, driver.h, project_config.h, regs_local.h, sbc2022_modbus.h]
2022-11-16 Somehow had driver.cpp that didn't work for Sensor. Added script to copy files from Relay to Sensor.
    [gpio.csv]
2022-11-27 Starting checkout of Relay board prototype. Mixed up console TX/RX. Clock symbol incorrectly set to 16MHz, should be 8. Added console commands to set ATN line for testing. Modded gpio scripts to use 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
    [Workbook.ods, checkout.ods, gpio.csv]
2022-11-27 Updating GPIO to match schematic, untested.
    [gpio.csv]
2022-11-29 Handle blinky LED warnings properly. Sensor was allowing MODBUS to write to tilt register, which is an error. Relay SPI driver attached to wrong pins. Threshold scanner broken. Rewrote sequencer in u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
    [Workbook.ods, checkout.ods]
2022-11-29 Closing out Relay checkout.
    [checkout.ods]
2022-12-05 Sensor board hardware checkout nearly done. Lots of issues.
    [checkout.ods]
2022-12-05 Changes to RELAY Slave code. Sensor was using wrong DC alarm. Fault timers now start running so will timeout and set faults unless refreshed. Sensor accelerometer sample average count set by register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
    [Slave.cpp, driver.cpp, regs_local.h]
2022-12-05 Codegen had error functions as methods, need to be functions. Redid regs to allow registers to be signed, as the accelerometer output is signed. Added litle tool to dump a set of registers at accurat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
    [reg-read.py]
2022-12-05 Added a CRITICAL(...) macro to utils for oneliner critical sections. Add support to regs for different formats for printing registers.
2022-12-05 Possibly local changes to Sensor Slave not incorporated into Relay Slave codebase.
    Slave.cpp:
    Added console command to flap ATN line.
    Added console command to print single register value, as dump was disturbing timing of accelerometer sampling.
    Added console command to print millis.
    Played with blinky LED driver.
    driver.cpp:
    Fault timer redone, looks identical to Relay Slave code.
    Removed Sensor MODBUS holding register write.
    Links on Sensor set MODBUS address.
    Lots of work on accelerometer reading.
    Redid 12V monitor scaling.
    Threshold scanner now working properly.
    Swap console TX, RX.
    [gpio.csv]
2022-12-05 Integrated changes from Sensor.Slave into Relay.Slave.
2023-01-18 Sharing app source files between Relay & Sensor.
2023-01-28 No need for grabfiles now sharing code in projects. Added script to read registers to debug pitch calc.
2023-01-30 Changed Relay project to use shared source files in Shared/Slave.
2023-01-30 Redid accelerometer reading. Added tests for bad sample rate and flag if tilt is changing. Removed debug code to dump MODBUS responses.
2023-01-30 Simplified fault reporting on Blinky LED. Sensor build script was not updating Slave.cpp properly.
2023-01-30 Adding Sargood controller project.
    [gpio.csv, gpio_2560.csv]
2023-02-02 Fixed horrible memory corruption bug where nvInit() copied much more memory from EEPROM over to RAM, stepping on the SoftSerial instance used for the serial port. I can't understand how this didn't g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
    [driver.cpp]
2023-02-02 Strange problem with MODBUS timeouts on first character in frame fixed by setting all F_CPU to 16000000, even for "C" files. Sargood controller reads sensor reading from Sensor with manual MODBUS req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
    [gpio.csv]
2023-02-03 Sensors now have status in a register as status code. Console baudrate increased to 38400. MODBUS timing now calculated from baudrate, and response timeout set explicitly.
2023-02-08 Gpio script passes lint. Event script has better error handling and can write out a sample file. Better tests for codegen.
    [event.local.h, events_mk.py]
2023-02-08 Adding in thread lib. Added window thresholder to utils.
2023-02-08 X console command now stops MODBUS dump as well. Added code to Sargood Slave.cpp to quesr slaves and do app stuff. Sort of works. Sensor now does 4 quadrant tilt calc, not tested. Each build only mon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
2023-02-11 Added console commands for presets. Refactored code for Sensor faults.
2023-02-14 Adding to instrumentation to debug system timing as sometimes a MODBUS read fails for unknown reasons.
    [gpio.csv]
2023-02-14 Moved Sargood MODBUS request scheduler to driver.
2023-02-14 Redid Sargod error handling again.
    [Slave.cpp, driver.cpp, modbus.cpp, modbus.h, regs_local.h, sbc2022_modbus.h]
2023-02-18 Redid relays in command processor. And simplified.
2023-02-23 Rewritten schedule compiles and sort of runs.
    [gpio_2560.csv]
2023-02-25 Clean up csv parser.
    [t.csv]
2023-03-01 Updating gpio spreadsheet to current schematic.
    [gpio_2560.csv]
2023-03-01 Renamed shared source file with main from Slave to main. Renamed Sargood/Slave to Sargood/Sargood.
    [gpio.csv, gpio_2560.csv]
2023-03-01 Final check in before migration to Mega2560.
    [gpio.csv]
2023-03-01 Sargood ported to Mega 2560!
    [gpio.csv, gpio_2560.csv]
2023-03-01 Copied from CallStation.
    [Workbook.ods, checkout.ods, gpio.csv]
2023-03-01 Added LCD, events, printf.
2023-03-02 Moving things around, sort of working to control slaves with update on LCD.
    [gpio.csv]
2023-03-04 Adding tests for printf.
2023-03-04 Added option to Unity to only report failing tests. Myprintf tests build and run.
    [event.local.h, grm.py, main.cpp, myprintf.cpp, myprintf.h, project_config.h, test_printf.cpp, unity_internals.h]
2023-03-06 Added endianness swapping to utils.
    [main.cpp, test_utils.cpp, utils.h]
2023-03-06 Changed names of Relay & Slave projects. Renamed spare IO to SP_n to keep names consistent across projects.
    [gpio.csv]
2023-03-06 Renamed spare IO to SP_n for consistency with other projects.
    [gpio.csv]
2023-03-09 Modbus broken something up with the 16 bit handling.
    [modbus.cpp, modbus.h]
2023-03-10 Rewrote modbus driver to be testable. Finally sorted out CRC weirdness. It's little endian on the wire, unlike the data which is big endian. utils BufferFrame a bit more const friendly. Really should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
    [grm.py, main.cpp, modbus.cpp, modbus.h, support_test.cpp, support_test.h, test_modbus.cpp, test_printf.cpp]
2023-03-10 Added tests to unconditional endianness swap functions.
    [main.cpp, test_utils.cpp]
2023-03-12 Tried out cppcheck, bit of a pain to configure, didn't really find any bugs. THREAD_YIELD terminallyconfuses it.
    [console.cpp, utils.h]
2023-03-12 Added simple class to replace Buffer in utils. Fixed bug where TT_TEST_CASE(...) would ignore instances with trailing comments.
    [buffer.h, grm.py, main.cpp]
2023-03-12 Fixed up Relay project to build. Reassigned Relay, Sensor spare IO pins to all remaining. Chasing printf bug showing from console cmd '1 event'. Think it was using snprintf instead of vsnprintf. Foun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
    [gpio.csv]
2023-03-20 Adding netlist script and source for Sargo prototype build.
2023-03-23 Building proto. Found VCC/GND reversed on LCD & RESET on wrong JTAG pin.
    [pcb-template.dxf]
2023-03-23 Added timeout to slew to positition. Made aure that start/stop events called for every event. Thought there was some promlem with event timers in event.cpp, not so sure now. Still a problem with prin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
    [app.cpp, app.h, event.cpp, event.h, main.cpp, myprintf.cpp, project_config.h, reg-read.py]
2023-03-26 Remapped Sargood serial ports. Added LCD BL control. Removed nets from Sargood proto that will not be built.
    [gpio.csv]
2023-03-27 Added switch scanner. Completely untested. I really have to get CI working. Or even install gcc-avr.
2023-03-27 Accelerometer data rate can now be set. Appears to make little difference to noise though.
    [driver.cpp, project_config.h]
2023-03-28 Switch scanner working.
2023-03-29 Added dual axis to command thread.
2023-03-29 LCD now shows sensor readings in real time. Sesnors have MODBUS register to record number of accelerometer samples missed since last read. Useful for optimising sample rate. Added fadeout to LCD back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
    [noise.ods, reqs.ods]
2023-03-30 Fixed bug in myprintf not found in testing on PC as sizeof myprintf's int & long int were equal. Unsigned ints were getting sign extended to 32 bits like they were ints.
    [myprintf.cpp, project_config.h]
2023-03-31 Can set accel data rate in Sensor. Sargood ignores repeated IR codes. Found bug in gcc, lots of undefined macros in irmp were setting off -Wundef, which can't be ignored with a pragma.
    [app.cpp, driver.cpp, main.cpp, modbus.cpp, modbus.h, project_config.h, regs_local.h]
2023-04-09 Made makefile universal so I can build any combination of tests. And fixed a few warnings in Common.
    [event.cpp, main.cpp, test_event.cpp, test_utils.cpp, utils.cpp, utils.h]
2023-04-19 Sargood Added beginnings of menu. Forgot ATN_IN pin. IR now throttles repeat codes back to sensible rate. Sensor: Accel driver much worked on, code improvements, got quad compensation going so can re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
    [gpio.csv]
2023-04-27 Streamlining printf tests.
2023-05-01 Removed lcd_driver from build as blocks too much, Added AsyncLiquidCrystal which behaves much better.
    Redid MODBUS error codes to allow a mask to be used to deteremine which ones get dumped.
    Added reguster for MODBUS error mask and slave ID for fine grained control of MODBUS event dumps.
    RX char timeout calc was wrong.
    Added individual fault counters for each sensor.
    Driver:
    Error handlimg for scan changed.
    Slave scan schedule now dumps a bit more info to log.
    App:
    Motor stop time extended to check for run on.
    Sensor values dumped at start of cmd thread.
    [AsyncLiquidCrystal.cpp, AsyncLiquidCrystal.h, LoopbackStream.cpp, LoopbackStream.h, app.cpp, driver.cpp, event.local.h, main.cpp]
2023-05-02 Added commands from RS232 device.
2023-05-02 Removing old bed controller def.
2023-05-03 Getting Arduino build script going again... think it works. Sensor has quad correct enabled by default. Enables reg now same as Sargood.
    [project_config.h, regs_local.h]
2023-05-03 Moved files around a bit for Sensor.
2023-05-04 Removed cr from all console output. Added concise & binary trace modes. Clear limits command now needs repeating 3 times. Can cancel Move To Preset with IR code or any serial chars. All legal command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
2023-05-05 Deleted old project.
    [gpio.csv]
2023-05-05 Removed threshold scanner from driver. Far too complicated. Redid scripts for building Arduino versions and fixed little build bugs.
    [AsyncLiquidCrystal.h, driver.cpp, driver.h, project_config.h, regs_local.h]
2023-05-15 As sent to James. Backlight controlled by awake state. Disabled touch buttons.
    [Workbook.ods]
2023-05-17 Old dwg deleted.
    [panel.dxf]
2023-05-17 Changed relay masks to only operate one at a time for release. Should also mod my Relay board so thet rev rly operates pwr rly as well with Schottky diode.
2023-05-19 At James suggestion made tilt scale a register option as he thought it would work better with less resolution.
    [driver.cpp, project_config.h, regs_local.h, snoise.py]
2023-05-22 Renamed debugging events from app as they names were too generic. Added extra debugging events to slew machine. Added extra deadband to slew to decide if to start motion, which is intended to be much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
    Added filter test command to console as we have to characterise the utils filter behaviour.
2023-05-23 Added gaurd to Relay to cut relays on Master timeout. Added ENABLES flag to defeat this. Better handling of errors in slew in Controller.
    [app.cpp, driver.cpp, regs_local.h]
2023-05-23 Relay gaurd conditions working. System appears to fail safe from all faulys during slew.
    [app.cpp, project_config.h]
2023-05-23 Forgot to add! Relay guard conditions working. System appears to fail safe from all faulys during slew. Also adding Arduino project zip archives.
    [driver.cpp, main.cpp, project_config.h, regs_local.h]
2023-05-24 Axis limits code was a bit broken. Now fixed. Found that gcc-avr does not warn if a local shadows a static, even if -Wshadow is used.
    [app.cpp, driver.cpp, driver.h, main.cpp, project_config.h]
2023-05-24 Arduino build scripts now delete archive just to be safe. Sensors orientated vertically now.
2023-05-31 Added buffer class and rewrote modbus to use it. Now to simplify modbus driver a lot.
2023-05-31 New modbus driver compiles.
2023-06-03 More porting. Likely lots of errors. But error handling is more robust.
    [buffer.h, driver.cpp, regs_local.h]
2023-06-05 Missed adding these to last commit.
    [app.cpp, regs_local.h]
2023-06-06 Rewrite of app. Full of errors and no worker thread.
    [app.cpp, app.h, driver.cpp, regs_local.h]
2023-06-07 Added new status for repeated jog commands that extend duration: APP_CMD_STATUS_OK_DURING_PENDING which is a sillky name I know. Added extra App fault flag to show when app is busy. Alows checking wi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
    [app.cpp, app.h, driver.cpp, driver.h, project_config.h, regs_local.h]
2023-06-07 Decided that commands do not need to idle for a bit to allow motors to run down. That is the job of the motor controller. So STOP command becomes rather trivial.
2023-08-24 Adding static templated Buffer class but problems with templated tests.
    [buffer.h, grm.py, test_buffer_dynamic.cpp, test_buffer_static.cpp]
2023-08-28 Changes requested by james when testing new board:
    * Remap buttons _from_ Ret Menu Right Left _to_ Ret Left Right Menu.
    * Change touch button disable flag to have correct action (was inverted).
    * Remap IR codes to suit James' remotes, see app.cpp.
    * Note trailing spaces removed as well.
    These changes will have to be merged with the new-modbus branch!
    [gpio.csv]
2023-08-28 Redid GPIO assignment to suit new board.
    [gpio.csv]
2023-08-28 Build 840 on way to James.
    [gpio.csv]
2023-08-28 IR codes need to be sorted. Menu & Left buttons still needed swapping.
    [gpio.csv]
2023-08-30 Added mode to disable wake state, backlight now just has timeout. If James wants the wake state shown can add a flag on the display.
    [app.cpp, driver.cpp, driver.h, event.local.h, main.cpp, project_config.h, regs_local.h]
2023-09-12 Fixed unknown error message when holding down og buttons.
    [app.cpp, app.h, project_config.h, regs_local.h]
2023-09-12 Slew timeout flag being set was preventing slew to pos command starting. Fixed by clearing flag for start check, but not for run check. Simplified slew to position logic. Added config register for ru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
    [app.cpp, driver.cpp, project_config.h, regs_local.h]
2023-09-12 Adding delay between motor stop & start for slew and run on delay for pos 1. Still not reliable.
2023-09-13 Redid app command handler. Not fully tested but as logic is much clearer should be easier to fix.
    [app.cpp, event.local.h, main.cpp, project_config.h]
2023-09-13 Added run on for pos 1 slew.
    Discrimiinator for slew position working correctly in dedband now.
    Added event for position after run down.
    [app.cpp, event.local.h, project_config.h]
2023-09-14 Cleanup of Sensor.
2023-09-14 Working on programming for Sensor boards.
2023-09-15 Fiddling with menu & gui. Added button repeats.
