celephicus/sbc2023/(notices)

Notices in the files:
Software/Shared/Common/src/myprintf.cpp:
This program is free software; you can redistribute it and/or modify
it under the terms of the GNU Lesser General Public License as published by
the Free Software Foundation; either version 2 of the License, or
(at your option) any later version.
